shivamndave/tiny_house/src/database/schema-simple.png

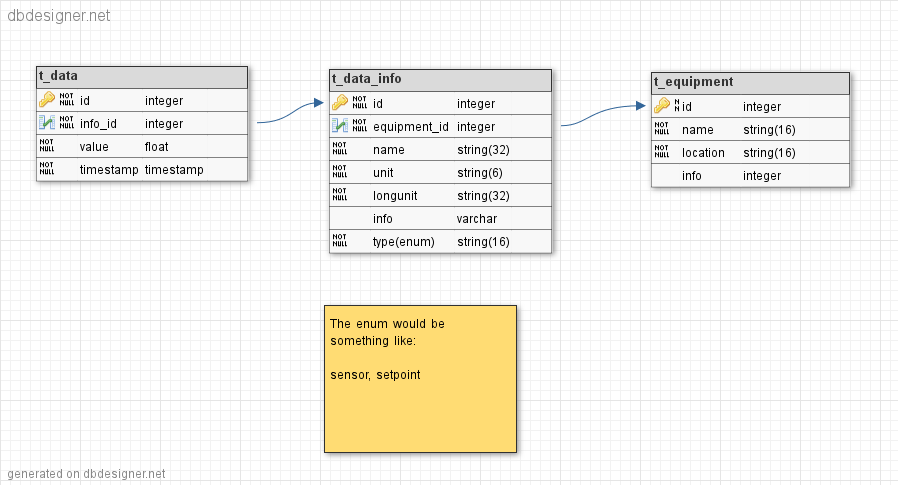
src/database/schema-simple.png
