shivamndave/tiny_house/src/database/schema.png

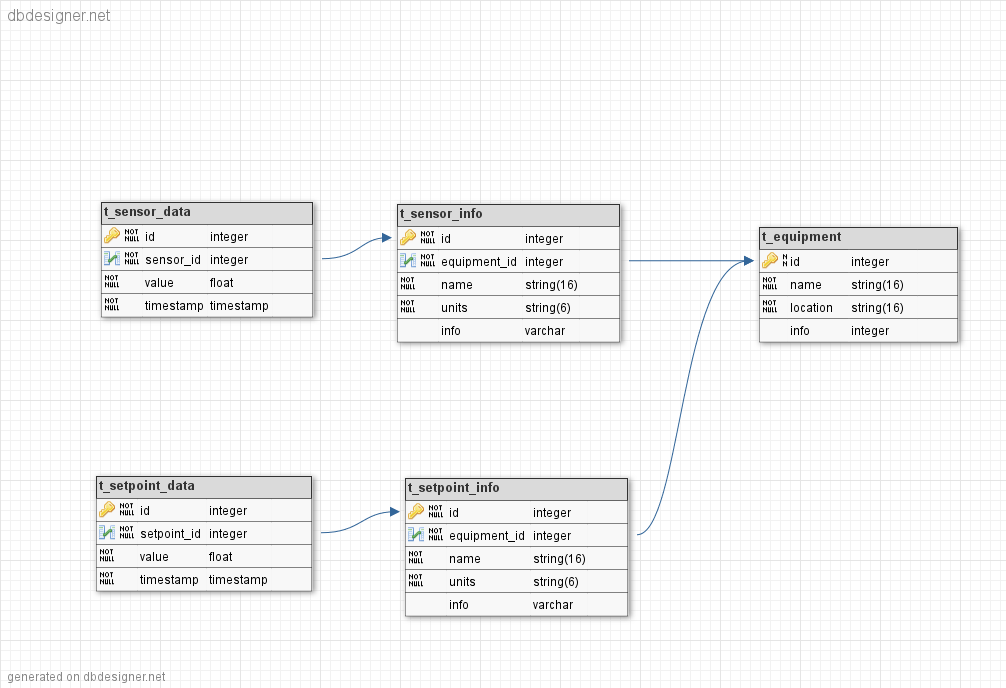
src/database/schema.png
