shivamndave/tiny_house/src/uC_schematic/pcb_topview.png

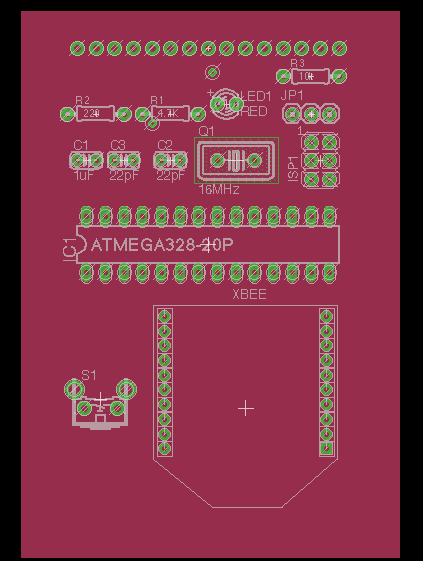
src/uC_schematic/pcb_topview.png
