shivamndave/tiny_house/(threads)

Thread 34 (2016-03-22):

Map page

shivamndave, 2016-03-22:
Can be a sample page to show the map of a user's home. Key issue is finding a library that will be helpful with implementing this

Closed 2016-05-27.
