shivamndave/tiny_house/src/uC_schematic/schematic.brd

## EAGLE design src/uC_schematic/schematic.brd (2015-11-07)

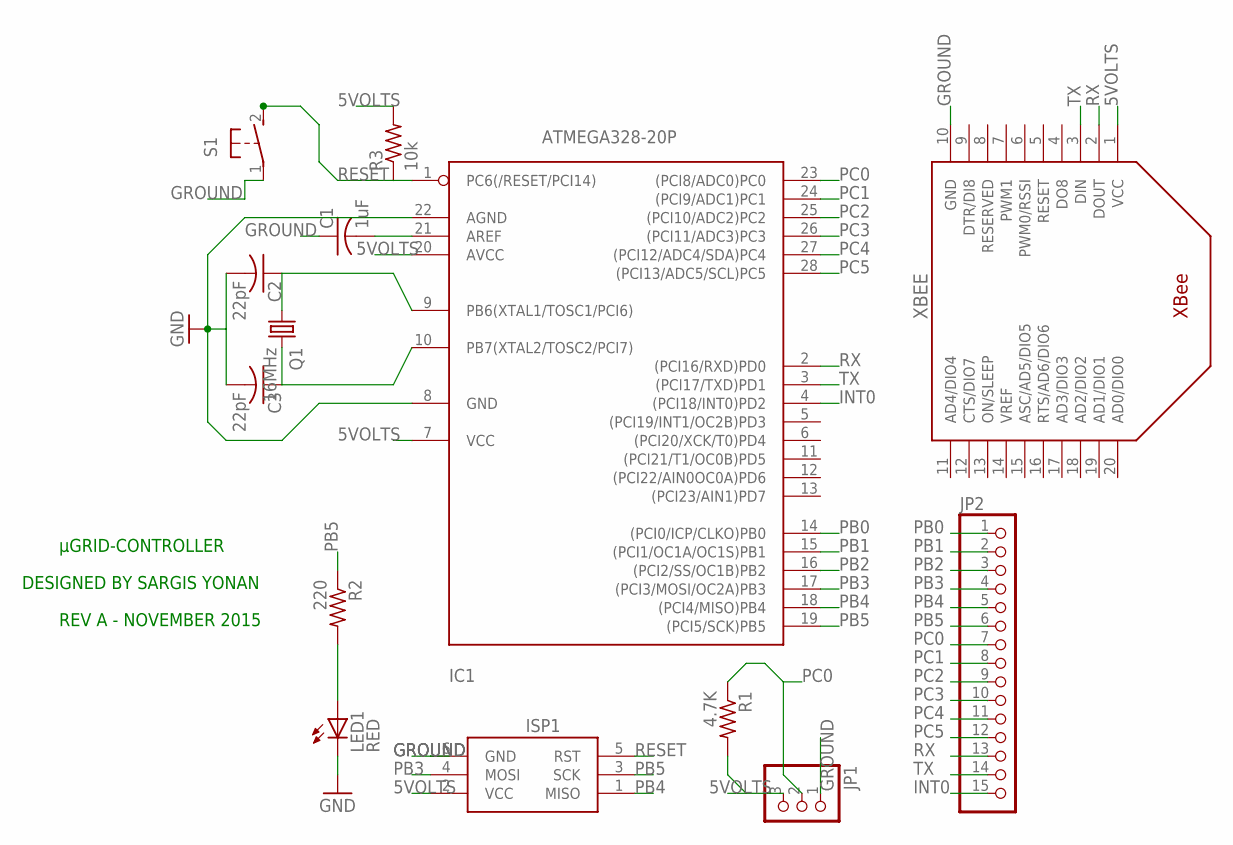
[picture p18: schematic schematic.sch]

Parts:
C1: 1uF; C025-024X044
C2, C3: 22pF; C025-024X044
IC1: ATMEGA328-20P; DIL28-3
ISP1: AVRISP-6; AVRISP
JP1: PINHD-1X3; 1X03
JP2: PINHD-1X15-CB; 1X15-CB
LED1: RED; LED3MM
Q1: 16MHz; HC18U-V
R1: 4.7K; 0204/7
R2: 220; 0204/7
R3: 10k; 0204/7
S1: 31-XX; B3F-31XX
XBEE: XBEE

Connections:
5VOLTS: IC1.7 (VCC), IC1.20 (AVCC), ISP1.2 (VCC), JP1.3, R1.2, R3.2, XBEE.1 (VCC)
GROUND: C1.1, C2.2, C3.2, IC1.8 (GND), IC1.22 (AGND), ISP1.6 (GND), JP1.1, LED1.K (C), S1.1, XBEE.10 (GND)
INT0: IC1.4 ((PCI18/INT0)PD2), JP2.15
unnamed: C1.2, IC1.21 (AREF)
unnamed: LED1.A, R2.2
unnamed: C2.1, IC1.9 (PB6(XTAL1/TOSC1/PCI6)), Q1.1
unnamed: C3.1, IC1.10 (PB7(XTAL2/TOSC2/PCI7)), Q1.2
PB0: IC1.14 ((PCI0/ICP/CLKO)PB0), JP2.1
PB1: IC1.15 ((PCI1/OC1A/OC1S)PB1), JP2.2
PB2: IC1.16 ((PCI2/SS/OC1B)PB2), JP2.3
PB3: IC1.17 ((PCI3/MOSI/OC2A)PB3), ISP1.4 (MOSI), JP2.4
PB4: IC1.18 ((PCI4/MISO)PB4), ISP1.1 (MISO), JP2.5
PB5: IC1.19 ((PCI5/SCK)PB5), ISP1.3 (SCK), JP2.6, R2.1
PC0: IC1.23 ((PCI8/ADC0)PC0), JP1.2, JP2.7, R1.1
PC1: IC1.24 ((PCI9/ADC1)PC1), JP2.8
PC2: IC1.25 ((PCI10/ADC2)PC2), JP2.9
PC3: IC1.26 ((PCI11/ADC3)PC3), JP2.10
PC4: IC1.27 ((PCI12/ADC4/SDA)PC4), JP2.11
PC5: IC1.28 ((PCI13/ADC5/SCL)PC5), JP2.12
RESET: IC1.1 (PC6(/RESET/PCI14)), ISP1.5 (RST), R3.1, S1.2 (S)
RX: IC1.2 ((PCI16/RXD)PD0), JP2.13, XBEE.2 (DOUT)
TX: IC1.3 ((PCI17/TXD)PD1), JP2.14, XBEE.3 (DIN)

Notes on the sheet:
DESIGNED BY SARGIS YONAN
REV A - NOVEMBER 2015
µGRID-CONTROLLER

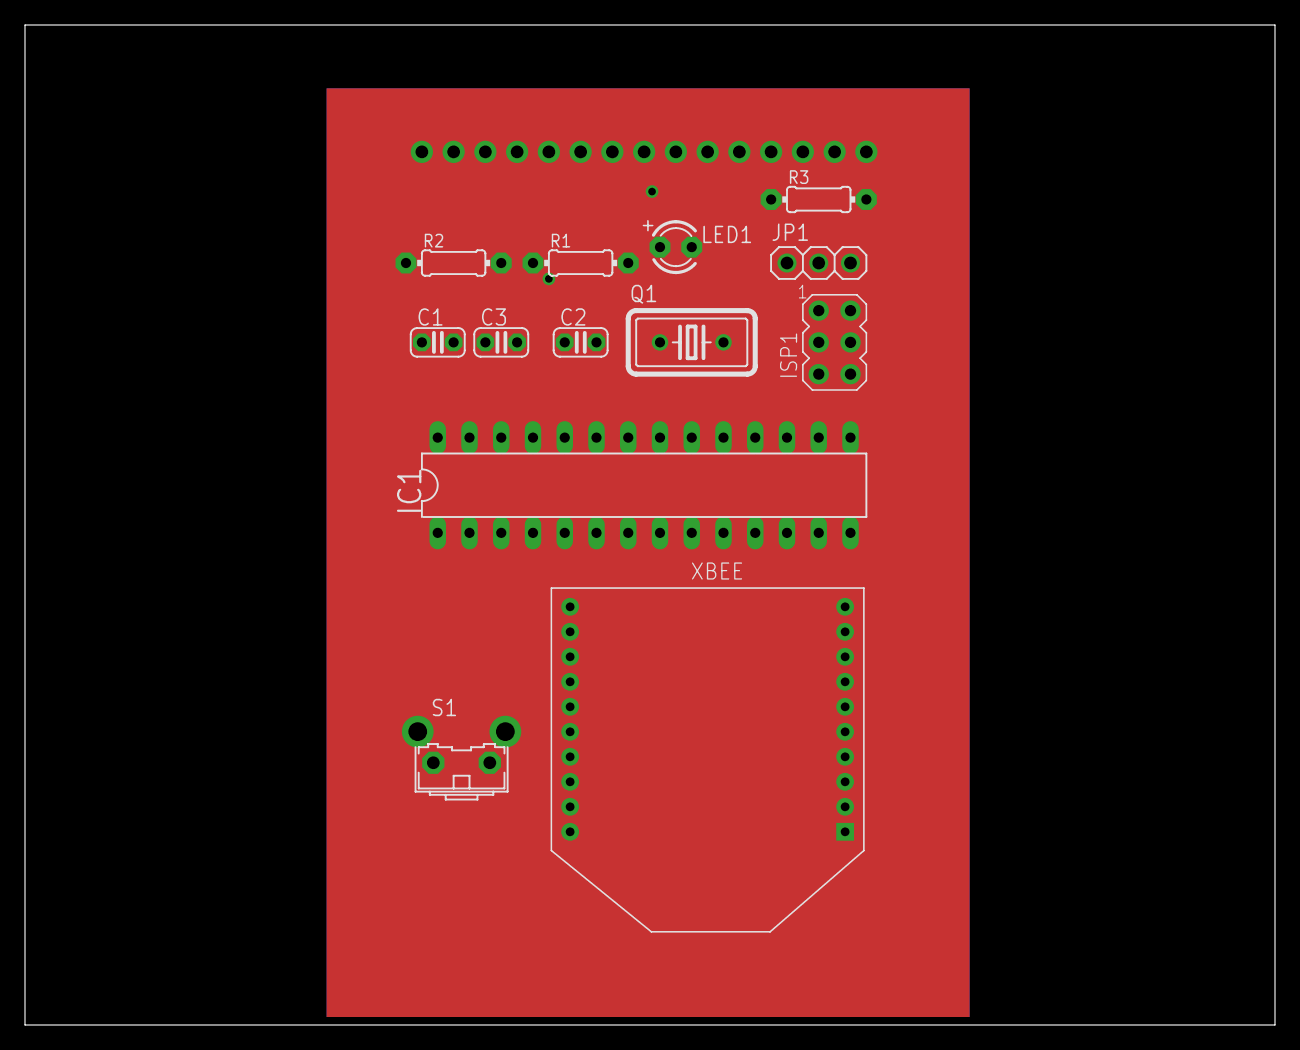
[picture p19: board schematic.brd from above]

Board: 2 copper layers, 100.0 x 80.0 mm, 14 parts (0 on the bottom side), 22 nets.
