shivamndave/tiny_house/(commit log)

2015-10-12 uart testing
2015-10-12 printing and uart libraries/Makefile I have worked on
2015-10-13 I wrote a printf function for the uC to write through the uart
2015-10-18 I wrote a new GrabString Function, UARTGrabString, that receives a string from USART0. A driver program is in uprintf.c
2015-10-19 bug fixes to the grabString function in the uart library
2015-10-21 Initial Commit of a sensor driver header file
2015-10-21 sesnor driver directory added + driver header file
2015-10-22 added driver template
2015-10-26 One wire library tests intact -no floating point conversion yet
2015-10-27 [UI] Setup RD
    Setup design to be responsive - as in the
    viewport will change width based on device.
    (Will implement media queries to have objects
    stack on small screens). However laid out grid frame
    with 2, 3, or 4 columns based on data being shown.
    Shows rough idea of how we may want to layout
    objects and used temporary colors/styles to
    showcase the objects.
2015-10-27 [UI] Menu/Header
    Switched the header info to the
    left and the 'menu' to the right.
2015-10-27 added F support for temperature
2015-11-14 added support for multiple uart channels and Xbee
2015-11-18 bug fixes in xbee rx/tx
    [driver.c, driver.h, main.c]
2015-11-21 added more tests, modified grabCommand() to take uint8_t. figured out the garbled input issue
    [main.c]
2015-11-22 [Cleanup]
    Renamed sensor ids and changed header info dummy
    data.
2015-11-23 error case added
2015-11-23 [JS/JSON]
    Made base freqeuncy/power files.
2015-11-23 [JSON]
    Power json file made.
2015-11-23 added functionality and error cases
    [driver.c, driver.h, main.c]
2015-11-23 updated schematics
2015-11-25 added rx frames
2015-11-30 Added revision 1 of working prototypes & known problems report
2015-11-30 Renamed powerDisplay to tempDisplay, also edited the temperature chart to be for temperature set points.
2015-11-30 [PHP]
    Edited the php file to take in new temperature set point values
    along with frequency and checks in the mysql query for info_id
2015-11-30 Reimported tempDisplay instead of powerDisplay
2015-12-08 Tests
    Added database test data that simulates powersurge and power failure.
2016-01-26 comment issue while compiling for mega
    [driver.h]
2016-03-08 Live.php finally pushed up, current version works for old db schema, will be retrofitted for new one
2016-03-08 Added changes to access sensor info and equipment on database tables.
2016-03-09 Added in actuator/sensor data retireval and other information. REQUIRES TESTING.
2016-03-09 Fixed actuator_info query to get info based on sensor_id
2016-03-09 HighCharts setup files for the sensor and actuator charts
2016-03-09 Fixed Actuator data/info by querying sensor_id instead of just id - fixed bug
2016-03-09 Fixed default sensor data for the general sensor chart
2016-03-09 Sensor/Equipment Info added:
    Added back jQuery calls to showcase equipment and sensor information
    in addition to the actuator setpoint that is actively updated based on setpoint
    changes.
2016-03-09 Added latest value status
    Now all sensors have their latest value displayed
    even if they do not have an actuator.
2016-03-28 Added db_credentials sample
2016-04-03 Added index.html file and loaded it with current libraries
2016-04-27 HomeController Formatted for Angular
    This is the updated home page with angular. It currently dynamically updates the
    front page using a directive for the displays. Actuator displays will be implemented next
    . Also planning on making it more robust, however this is the home page conversion we want
2016-04-27 [Display]
    display.html is the template for the display directive
    used to populate the homepage. It is currently where the updating
    of the frontend happens, that will most likely change in the future
2016-05-06 Added rooms with sensors api call and slightly changed flask sensors call
2016-05-13 Fixed sensors API to be modular and added functionality to select sensor by id
2016-05-13 [maps]
    The maps is a web page that will serve as the directory page for the user. Fun and interactive users can navigate through their sensors with ease.
2016-05-13 [Sensors Page addition] This is where the new sensors page will be implemented
2016-05-13 Moved from Commands to OnBoard
    OnBoard currently is a page to enter a message
    and it will be sent out over mqtt. This shows
    that subscription/publishing works because of
    how the messages that are sent over a topic are
    displayed on the screen dynamically:
2016-05-20 These commits include: A whole new nav bar, new css styling for the web page, bugs and glitches are fixed in the sensors page, modularity with three of the pages is around 95% complete
2016-05-20 [Onboard]
    Controller sends start message to the nodediscover, and subscribes
    to another wildcard topic. Based on what is returned as a message and
    utilizing the topic's mac-addr, numbers of sensors is found, parsed, and
    builds a partially filled form.
2016-05-20 few styling changes made and circular knobs and toggle radio switches implemented
2016-05-26 Added a function and query for getting just mac addresses of equipment.Returns of current equipment mac addresses in a list
2016-05-26 [Onboard]
    Query to poast a new sensor to the database. Also associatates
    a mac_address with a piece of equipment when doing the post call
    . If the mac_address exists, then a new piece of equipment is not
    inserted (because one exists), otherwise the new equipment is added
    to t_equipment. Next the equipment id is obtained and the new sensor
    is inserted into the database
2016-05-26 [Onboard]
    Added service to post a new sensor to the database, calls
    our api to post a new sensor and equipment if new
2016-05-26 Disable submit button on successfully added a new sensor to the database
2016-05-27 Removed additional room query and such. Defaults new equipment to default first room. This allows quick addition of new equipment/sensor pairings. Also removed additional/unneeded queries/form inputs.
2016-05-27 Added actuator check to new sensor api
2016-05-27 Fixed uid's for sensors, now are appropriate and match commands
2016-05-27 HTML adjusted for adding actuator
2016-05-27 Added command for a light sensor
2016-05-27 Adds on/off button for actuators, used for light sensor (currently light sensor for all sensors)
2016-05-27 [Onboard] Bug
    Fixed bug where not all sensors passed into sensor_array for onboarding. Now
    we use a scope variable to keep track of the array
2016-05-27 [Commands]
    Added charting service and added actuation reading. Latest actuator value
    associated with the chart will be added to the chart and displayed. If a change
    occurs, it updates the chart.
2016-05-28 Added a actuator data call that posts a piece of data to the database
2016-05-28 Added buttons based on types of sensor/actuators used
2016-05-28 Added setpoint test functions/buttons that send a new datapoint to the database. This is setup for reza's setpoint knob
2016-05-28 Fixed actuator bug that does not insert actuator_info for correct one
2016-05-28 Added all needed buttons for all light sensor commands
2016-05-28 Added functions for all buttons. AO1, 2, 3, AA, AS, and actuation for each individual light added
2016-06-02 API
    Actuator queries added. Able to query for all or specific, similar to
    sensors
2016-06-02 Settings
    Changed settings page to accomodate settings page and angular-ui
    lib. Also nav bar adjusted for settings button
2016-06-02 Settings
    Settings HTML pages added for all sensors and specific sensors
2016-06-04 API
    Fixed the actuator API call's sensor_info. Now not a one element array
2016-06-04 API
    All settings page update calls added to adjust necessay info for a
    room, sensor, actuator and equipment.
2016-06-04 API
    Properly updates the si call for actuators based on previous bug fix
2016-06-04 Settings
    Actuator settings html page
2016-06-04 Settings
    Html sensors page adjusted for proper postData
